Team-RoboManipal-RoboCup/docs/source/electronics/index.md

# Electronics

```{toctree}
:maxdepth: 2

base/index
arm/index
```
