Team-RoboManipal-RoboCup/docs/source/electronics/base.md

# Base

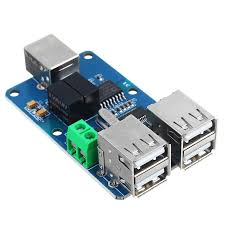
[picture p1: assets/ADUM3160.jpg]
ADUM3160


## Using ADUM3160 Bidirectional Digital USB Isolator for the signal isolation between jetson, base stm
