Team-RoboManipal-RoboCup/docs/source/electronics/arm/index.md

# Arm

```{toctree}
:maxdepth: 1

arm_pcb
motors
```
