Team-RoboManipal-RoboCup/docs/source/electronics/base/index.md

# Base

```{toctree}
:maxdepth: 1

base_pcb
optical_flow
motor_and_drivers
sensor_fusion
elec_box
```
