Team-RoboManipal-RoboCup/docs/source/coding/navigation/index.md

# Navigation

```{toctree}
:maxdepth: 1

odometry
slam_localization
shelf_alignment
```
