Team-RoboManipal-RoboCup/docs/source/autonomy/index.md

# Autonomy

The autonomy system provides high-level mission management, referee box communication, and task planning for RoboCup Smart Manufacturing League (SML) competitions. 

Operating above the navigation and manipulation layers, the global task planner translates competition orders (produce and recycle) into ordered action sequences using classical automated planning frameworks.

```{toctree}
:maxdepth: 2
:caption: Autonomy Modules

task_planning
```
