Team-RoboManipal-RoboCup/docs/assets/amr_electrical_architecture.png

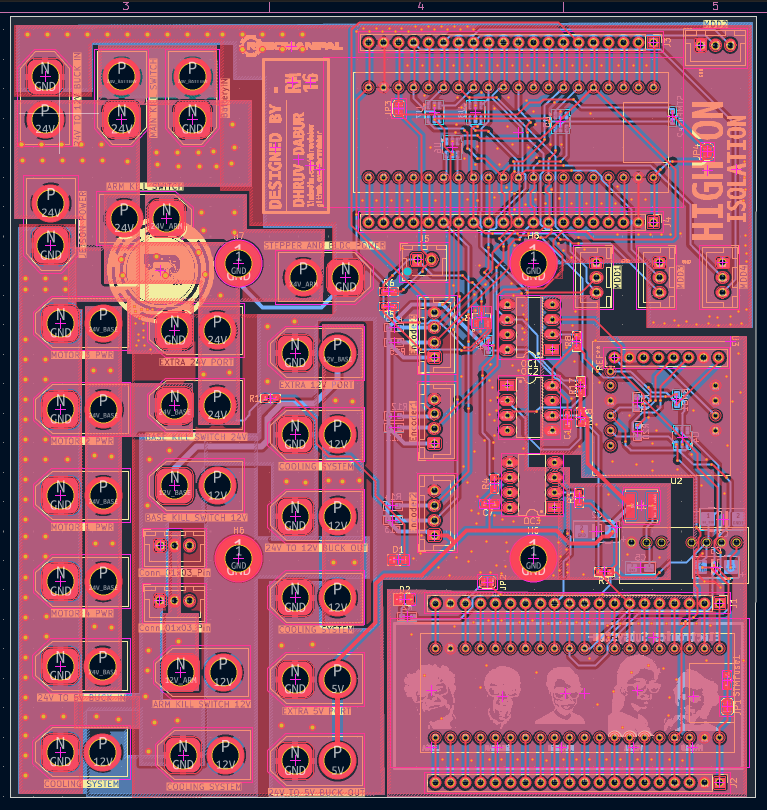
assets/amr_electrical_architecture.png
