Team-RoboManipal-RoboCup/docs/assets/arm_pcb_kicad.jpg

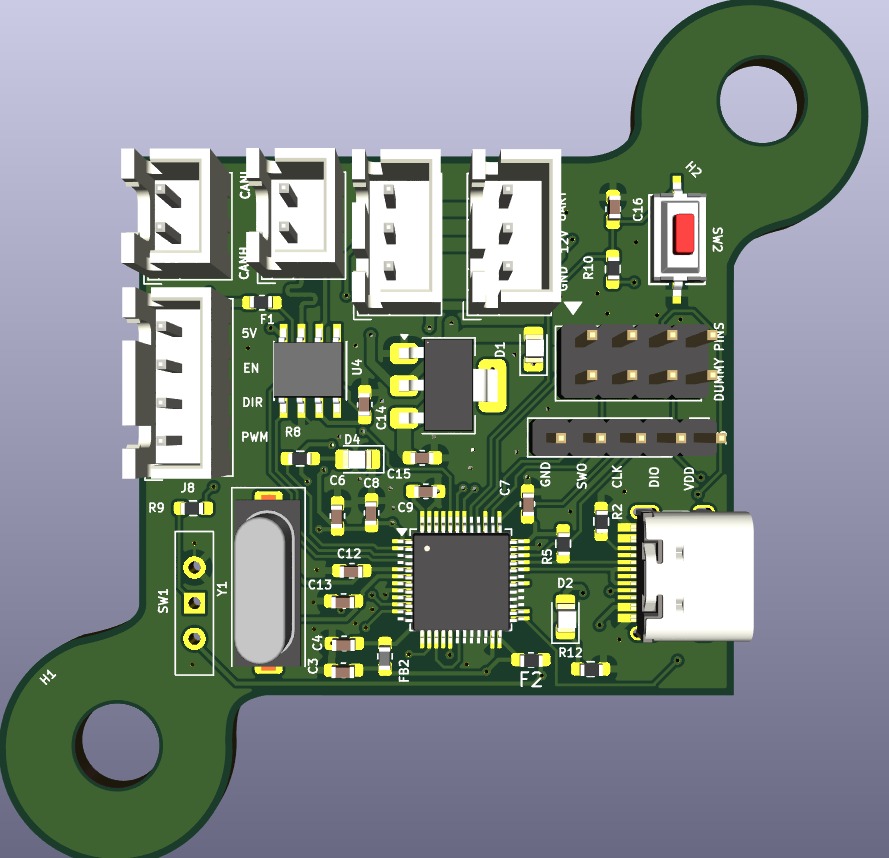
assets/arm_pcb_kicad.jpg
