Team-RoboManipal-RoboCup/docs/assets/cf_joint_mount.jpg

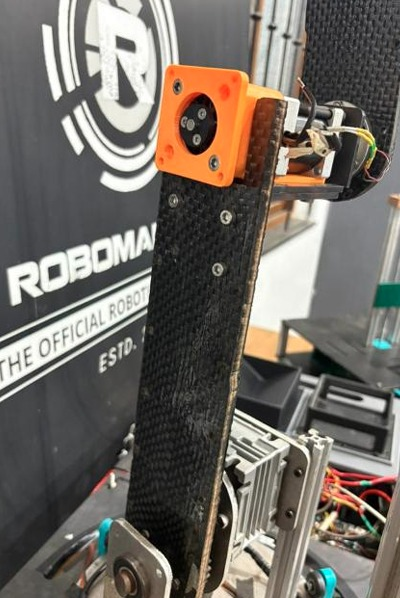
assets/cf_joint_mount.jpg
