Team-RoboManipal-RoboCup/docs/assets/cf_plain_weave.jpg

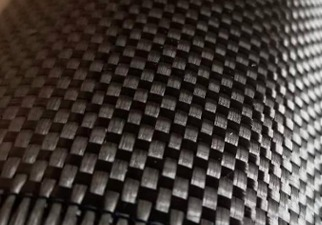
assets/cf_plain_weave.jpg
