Team-RoboManipal-RoboCup/docs/assets/cycloidal_cad_top.jpg

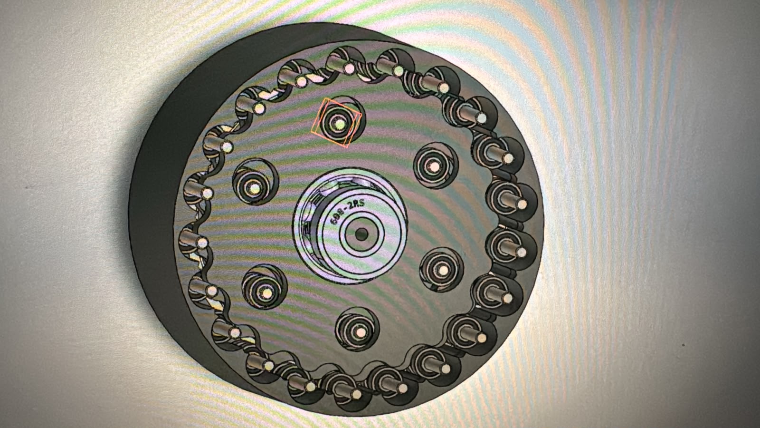
assets/cycloidal_cad_top.jpg
