Team-RoboManipal-RoboCup/docs/assets/cycloidal_cross_section.jpg

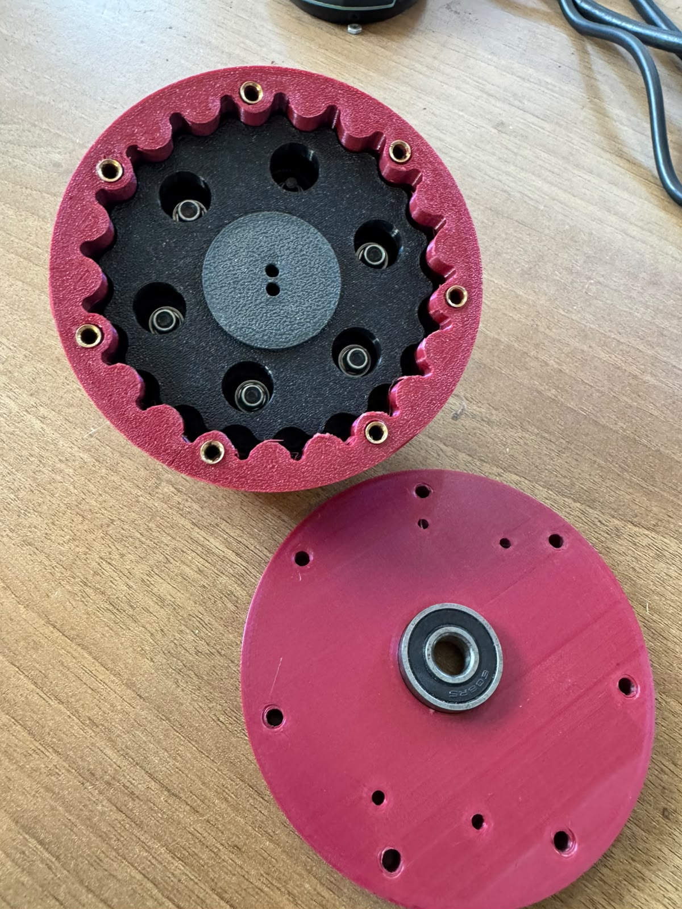
assets/cycloidal_cross_section.jpg
