Team-RoboManipal-RoboCup/docs/assets/dual_stm_topology.png

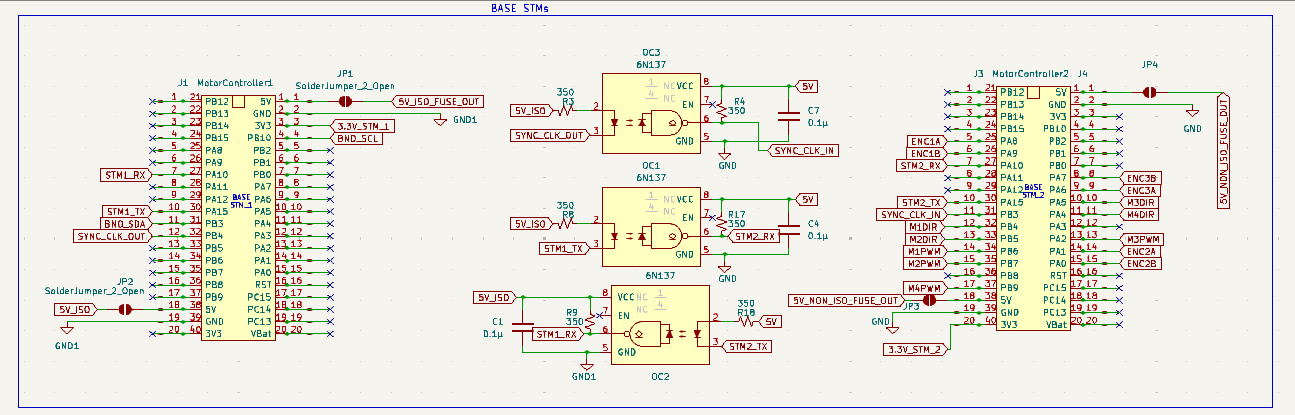
assets/dual_stm_topology.png
