Team-RoboManipal-RoboCup/docs/assets/gripper_render.jpg

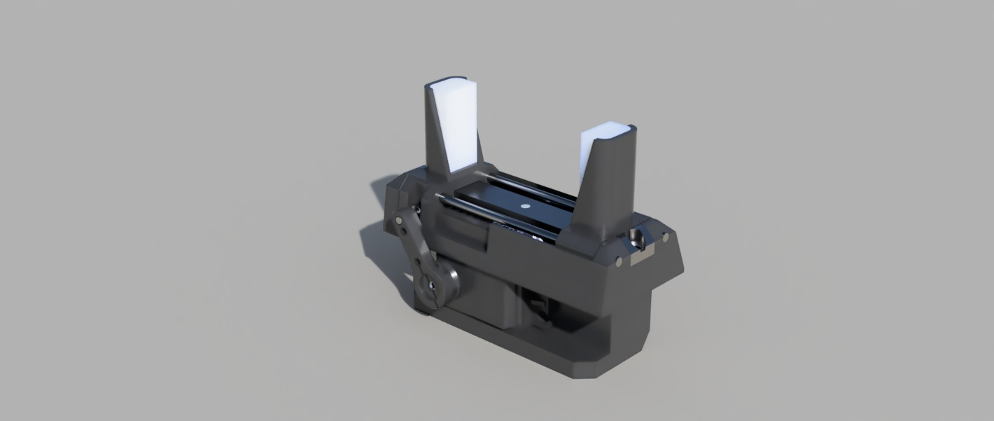
assets/gripper_render.jpg
