Team-RoboManipal-RoboCup/docs/assets/locking_disc_kidney_slots.png

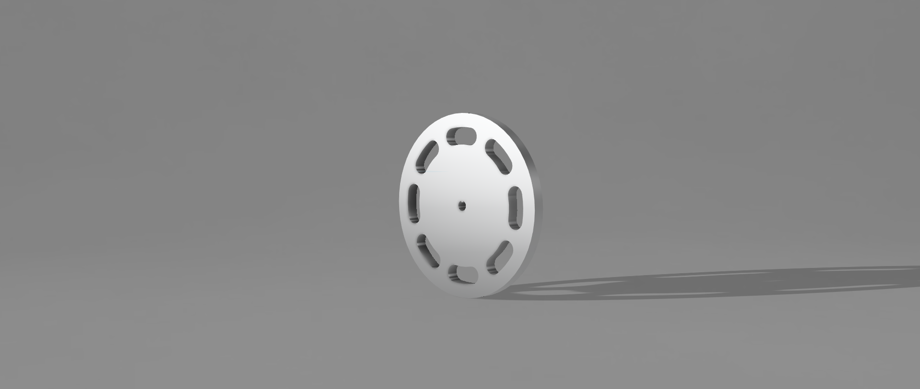
assets/locking_disc_kidney_slots.png
