Team-RoboManipal-RoboCup/docs/assets/mecanum_chassis_cad.jpg

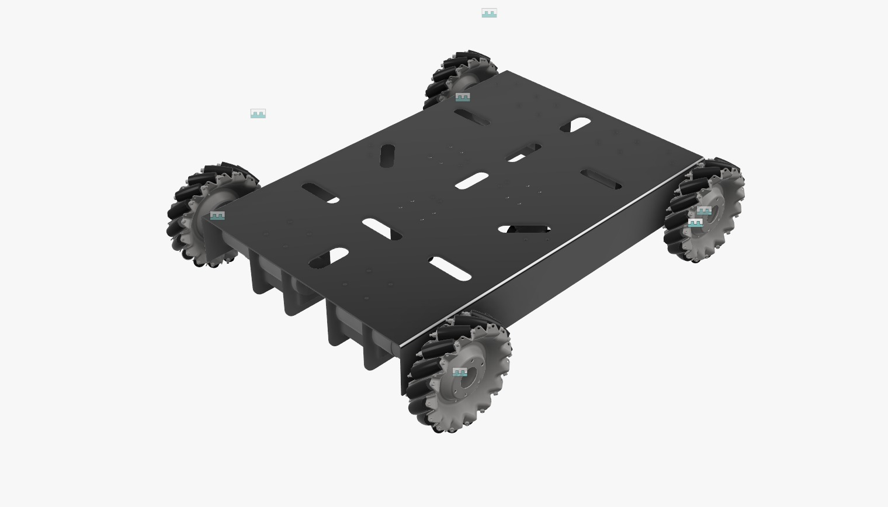
assets/mecanum_chassis_cad.jpg
