Team-RoboManipal-RoboCup/docs/assets/normal_pointcloud.png

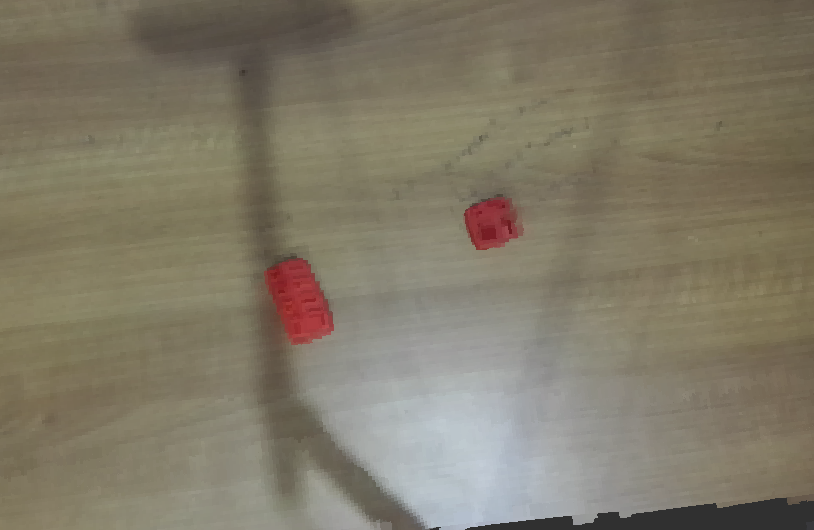
assets/normal_pointcloud.png
