Team-RoboManipal-RoboCup/docs/assets/pcb_unmasked_traces.png

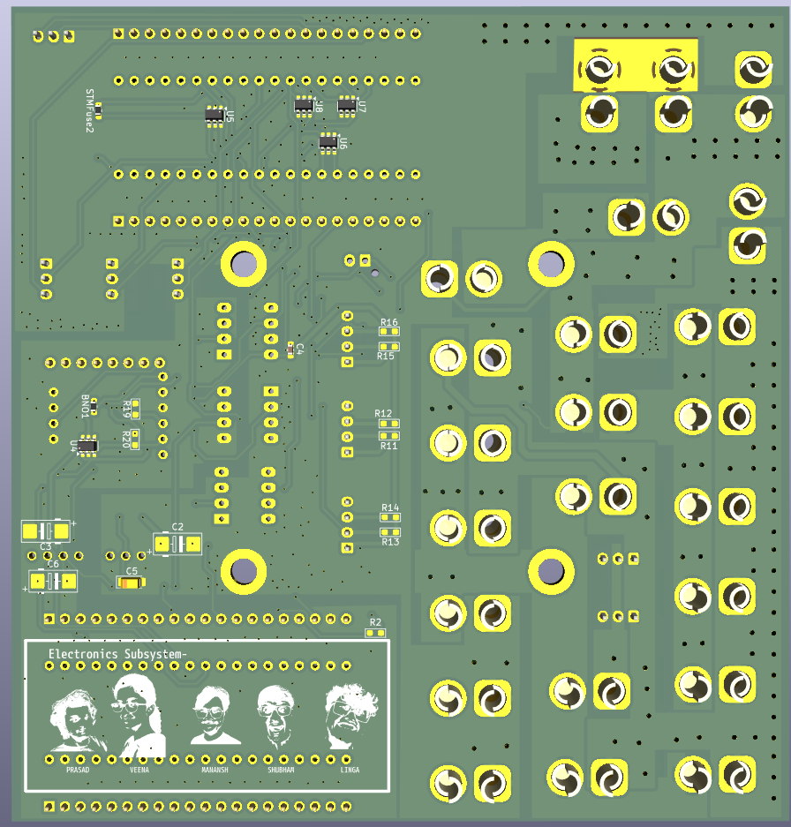
assets/pcb_unmasked_traces.png
