Team-RoboManipal-RoboCup/docs/assets/switch_schematic.png

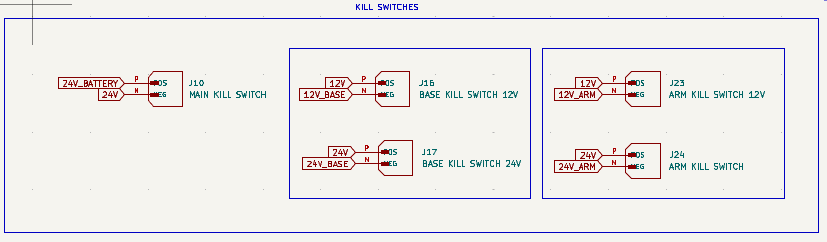
assets/switch_schematic.png
