Team-RoboManipal-RoboCup/docs/assets/task_msg_structure.jpg

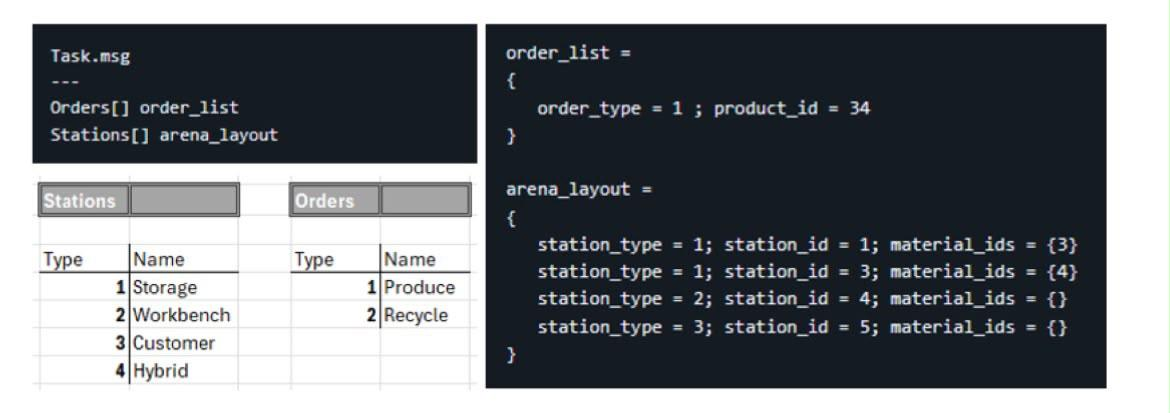
assets/task_msg_structure.jpg
