Team-RoboManipal-RoboCup/docs/assets/task_planner_execution_log.jpg

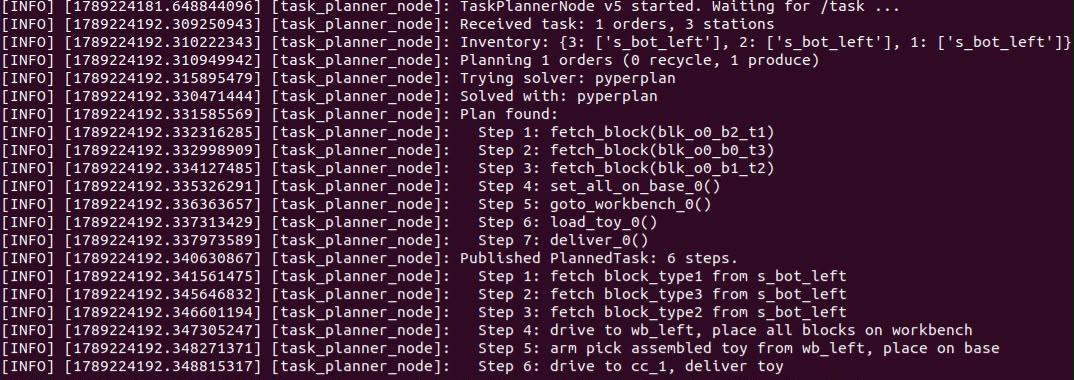
assets/task_planner_execution_log.jpg
