Team-RoboManipal-RoboCup/docs/assets/warehouse_exec_fetch.jpg

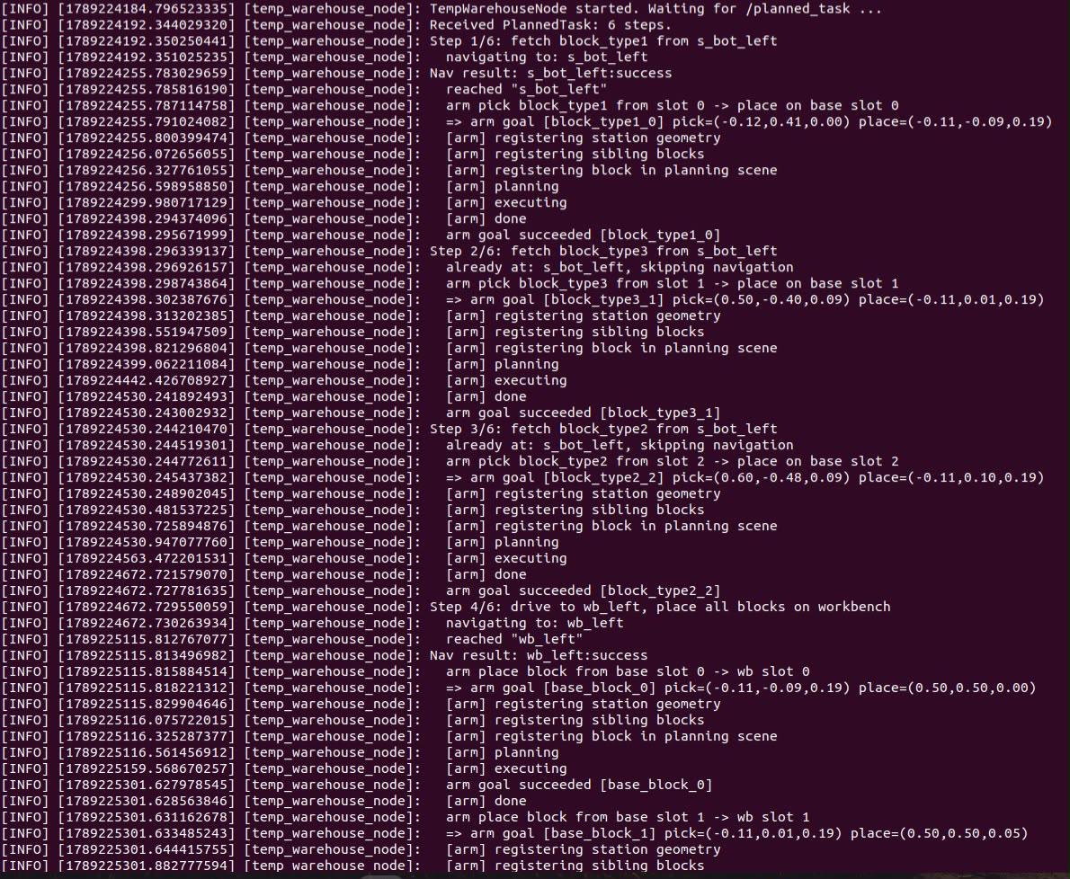
assets/warehouse_exec_fetch.jpg
