Team-RoboManipal-RoboCup/docs/(list of files, cad)

Other CAD files:
assets/gripper_assembly.f3z
