Team-RoboManipal-RoboCup/docs/source/design_fabrication_manufacturing/index.md

# Design Fabrication Manufacturing

```{toctree}
:maxdepth: 2

arm/index
base/index
fea
```
