Team-RoboManipal-RoboCup/docs/source/design_fabrication_manufacturing/arm/index.md

# Arm

```{toctree}
:maxdepth: 1

gripper
gearbox
composites
locking_mechanism
kinematics_and_dynamics
```
