Team-RoboManipal-RoboCup/docs/source/design_fabrication_manufacturing/base/index.md

# Base

```{toctree}
:maxdepth: 1

odometry
elec_box
drivetrain
```
