Team-RoboManipal-RoboCup/docs/source/design_fabrication_manufacturing/base.md

# Base

Base Animation
