Team-RoboManipal-RoboCup/docs/assets/cycloidal_assembled.jpg

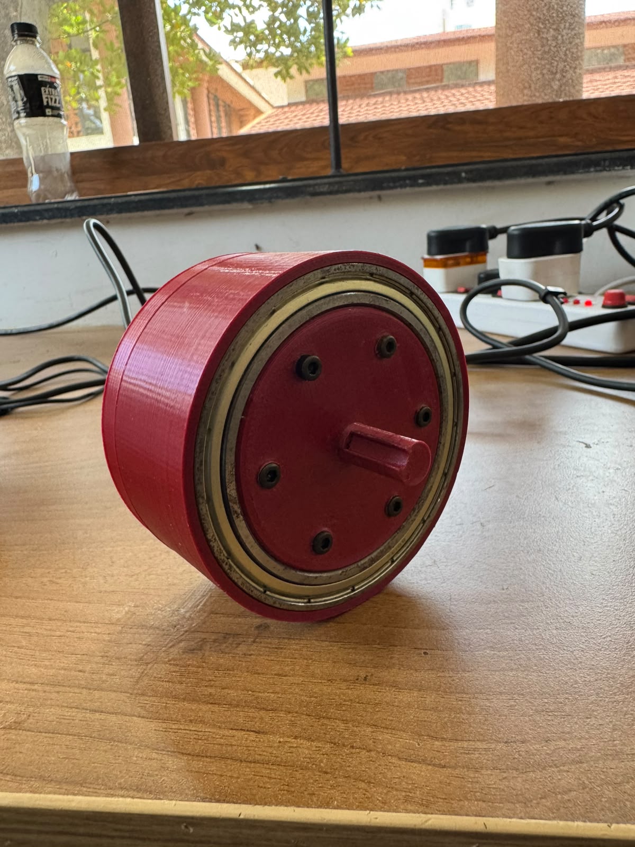
assets/cycloidal_assembled.jpg
