Team-RoboManipal-RoboCup/docs/assets/optical_flow_assembly.jpg

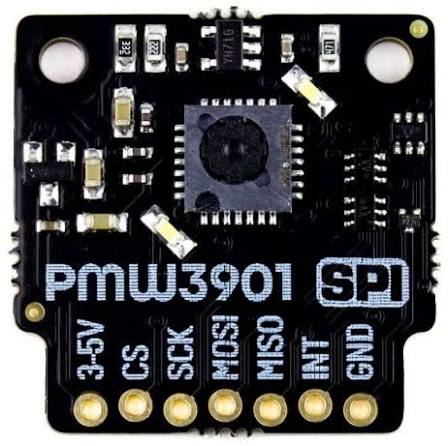
assets/optical_flow_assembly.jpg
