Team-RoboManipal-RoboCup/docs/assets/product_assembly_catalog.jpg

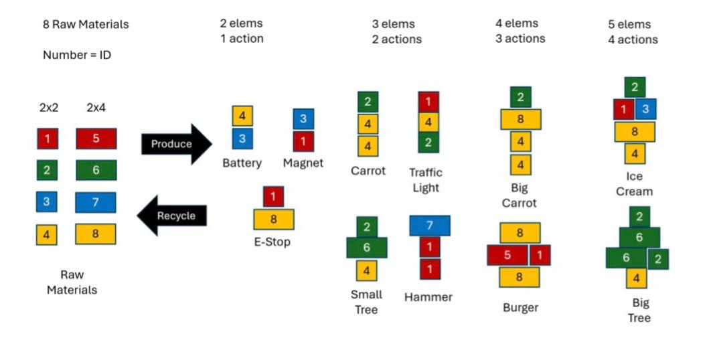
assets/product_assembly_catalog.jpg
